LSzczur/smog-detector/README.md

## SMOG Detector - Homemade Air Pollution Sensor

Documentation is still in development stage - if you have any questions please contact me or create an issue.
