LSzczur/smog-detector/source/tools/README.txt

path to install:
C:\Program Files (x86)\Arduino\tools
