LSzczur/smog-detector/hardware/Schematic.pdf

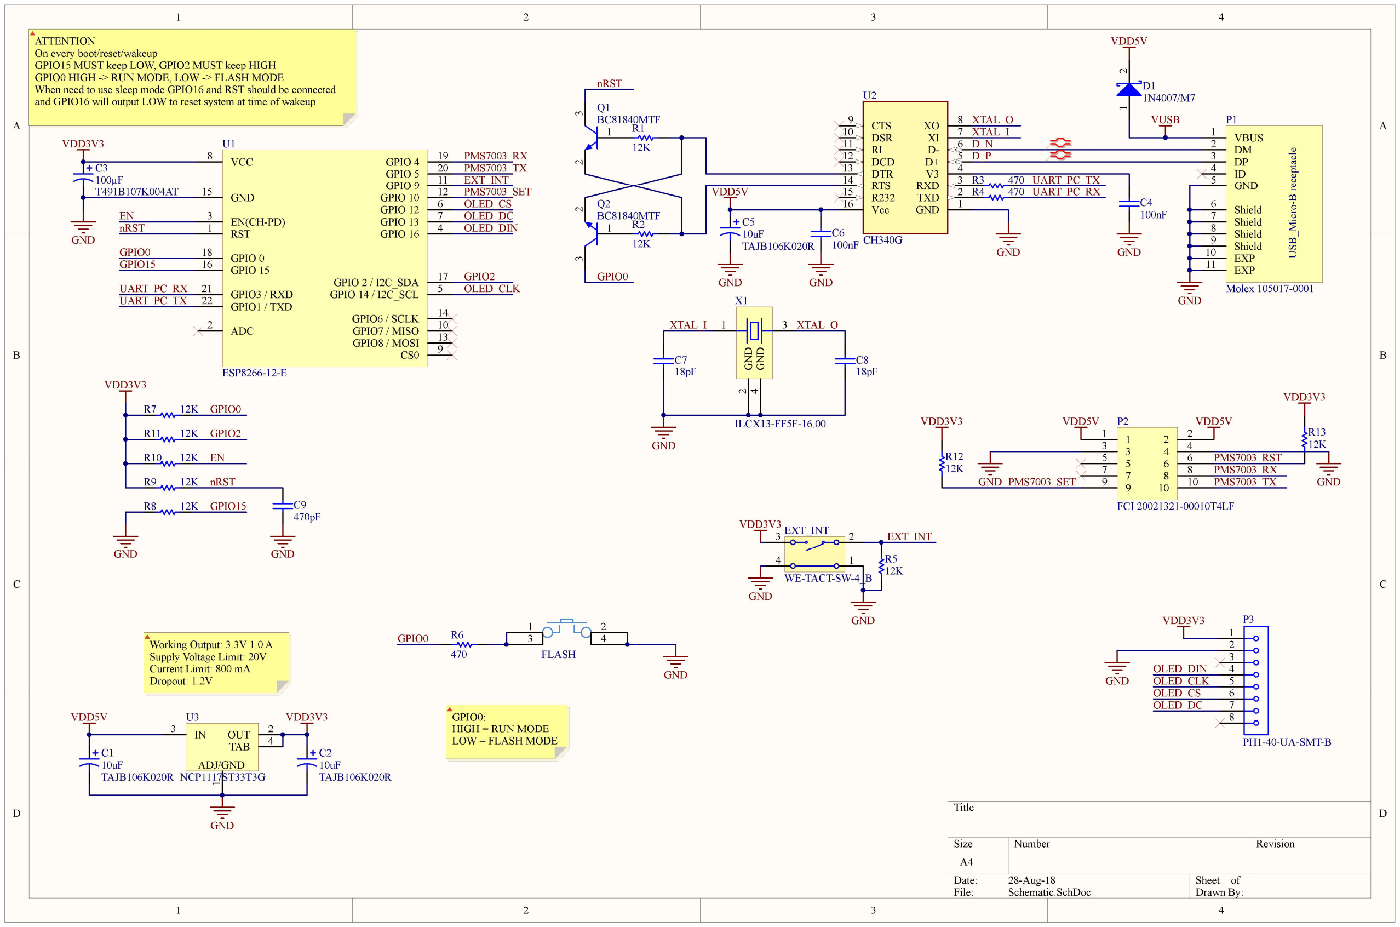
[picture p1: page 1]

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
Title

Size | Number | Revision
A4
Date: | 28-Aug-18 | Sheet of
File: | Schematic.SchDoc | Drawn By:

UART_PC_TX

UART_PC_RX

VBUS 1
DM 2
DP 3
ID 4
GND 5
Shield 6 | USB_Micro⁻B receptacle Shield 7

Shield 8
Shield 9
EXP 10
EXP 11

P1

Molex 105017-0001

VUSB

GND

VDD3V3

GND | 1
TXD | 2
D+ | 5
D- | 6
RXD | 3
V3 | 4

CTS 9
DSR 10

DTR 13
RTS 14
R232 15
Vcc 16
XI | 7
XO | 8

RI 11
DCD 12

U2

CH340G

R3 | 470
R4 | 470

UART_PC_TX
UART_PC_RX

GND

VDD5V

C6
100nF

GND
GND

C4
100nF

GND

XTAL_O
XTAL_I

T491B107K004AT

C3
100µF

1

OUT 2

IN 3
TAB 4

ADJ/GND

U3

NCP1117ST33T3G

1 2 3

Q1
BC81840MTF

### 1 ² 3

Q2

BC81840MTF | 1 2 | D1
| | 1N4007/M7

VDD5V

R1
12K

R2
12K

nRST

GPIO0

GND

VDD5V | VDD3V3

C9
470pF

VDD3V3

GND

1 3 GND

## 4 GND

2

X1

ILCX13-FF5F-16.00
GND

TAJB106K020R

C2
10uF
TAJB106K020R

C1
10uF

TAJB106K020R

C5
10uF

XTAL_O

GND

EN
nRST
R11 | 12K
R9 | 12K
R8 | 12K

GPIO0

GPIO2

EN

nRST

GPIO15

GND

GPIO0
GPIO15

PMS7003_RX
PMS7003_TX
EXT_INT
PMS7003_SET
OLED_CS
OLED_DC
OLED_DIN

GPIO2
OLED_CLK

VDD3V3

GND

OLED_DIN
OLED_CLK
OLED_CS
OLED_DC

D_N
D_P

XTAL_I

VDD5V | VDD5V
GND | GND

PMS7003_RST
PMS7003_RX
PMS7003_TX

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
10 10

P2

FCI 20021321-00010T4LF

GND

R7 12K GPIO0

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
PH1-40-UA-SMT-B

C8
18pF

C7
18pF

GND

GND

R5
12K

VDD3V3
EXT_INT

GPIO1 / TXD 22 GPIO3 / RXD 21

RST 1

EN(CH-PD) 3

GPIO8 / MOSI | 13 GPIO7 / MISO | 10 GPIO6 / SCLK | 14
CS0 | | | 9
GPIO 14 / I2C_SCL | 5
GPIO 2 / I2C_SDA | 17
GPIO 4 | 19
GPIO 5 | 20
GPIO 9 | 11
GPIO 10 | 12
GPIO 12 | 6
GPIO 13 | 7

GPIO 0 18
GPIO 15 16

GPIO 16 4

VCC 8

ADC 2

GND 15

U1

ESP8266-12-E

1 2
3 4
FLASH

1

3 2

4

EXT_INT

WE-TACT-SW-4_B

R10 | 12K | R12 12K

VDD3V3
R13
12K

VDD3V3

PMS7003_SET

ATTENTION
On every boot/reset/wakeup
GPIO15 MUST keep LOW, GPIO2 MUST keep HIGH
GPIO0 HIGH -> RUN MODE, LOW -> FLASH MODE
When need to use sleep mode GPIO16 and RST should be connected and GPIO16 will output LOW to reset system at time of wakeup

Working Output: 3.3V 1.0 A Supply Voltage Limit: 20V
Current Limit: 800 mA
Dropout: 1.2V

GPIO0:
HIGH = RUN MODE
LOW = FLASH MODE
