LSzczur/smog-detector/hardware/Assembly Drawings.pdf

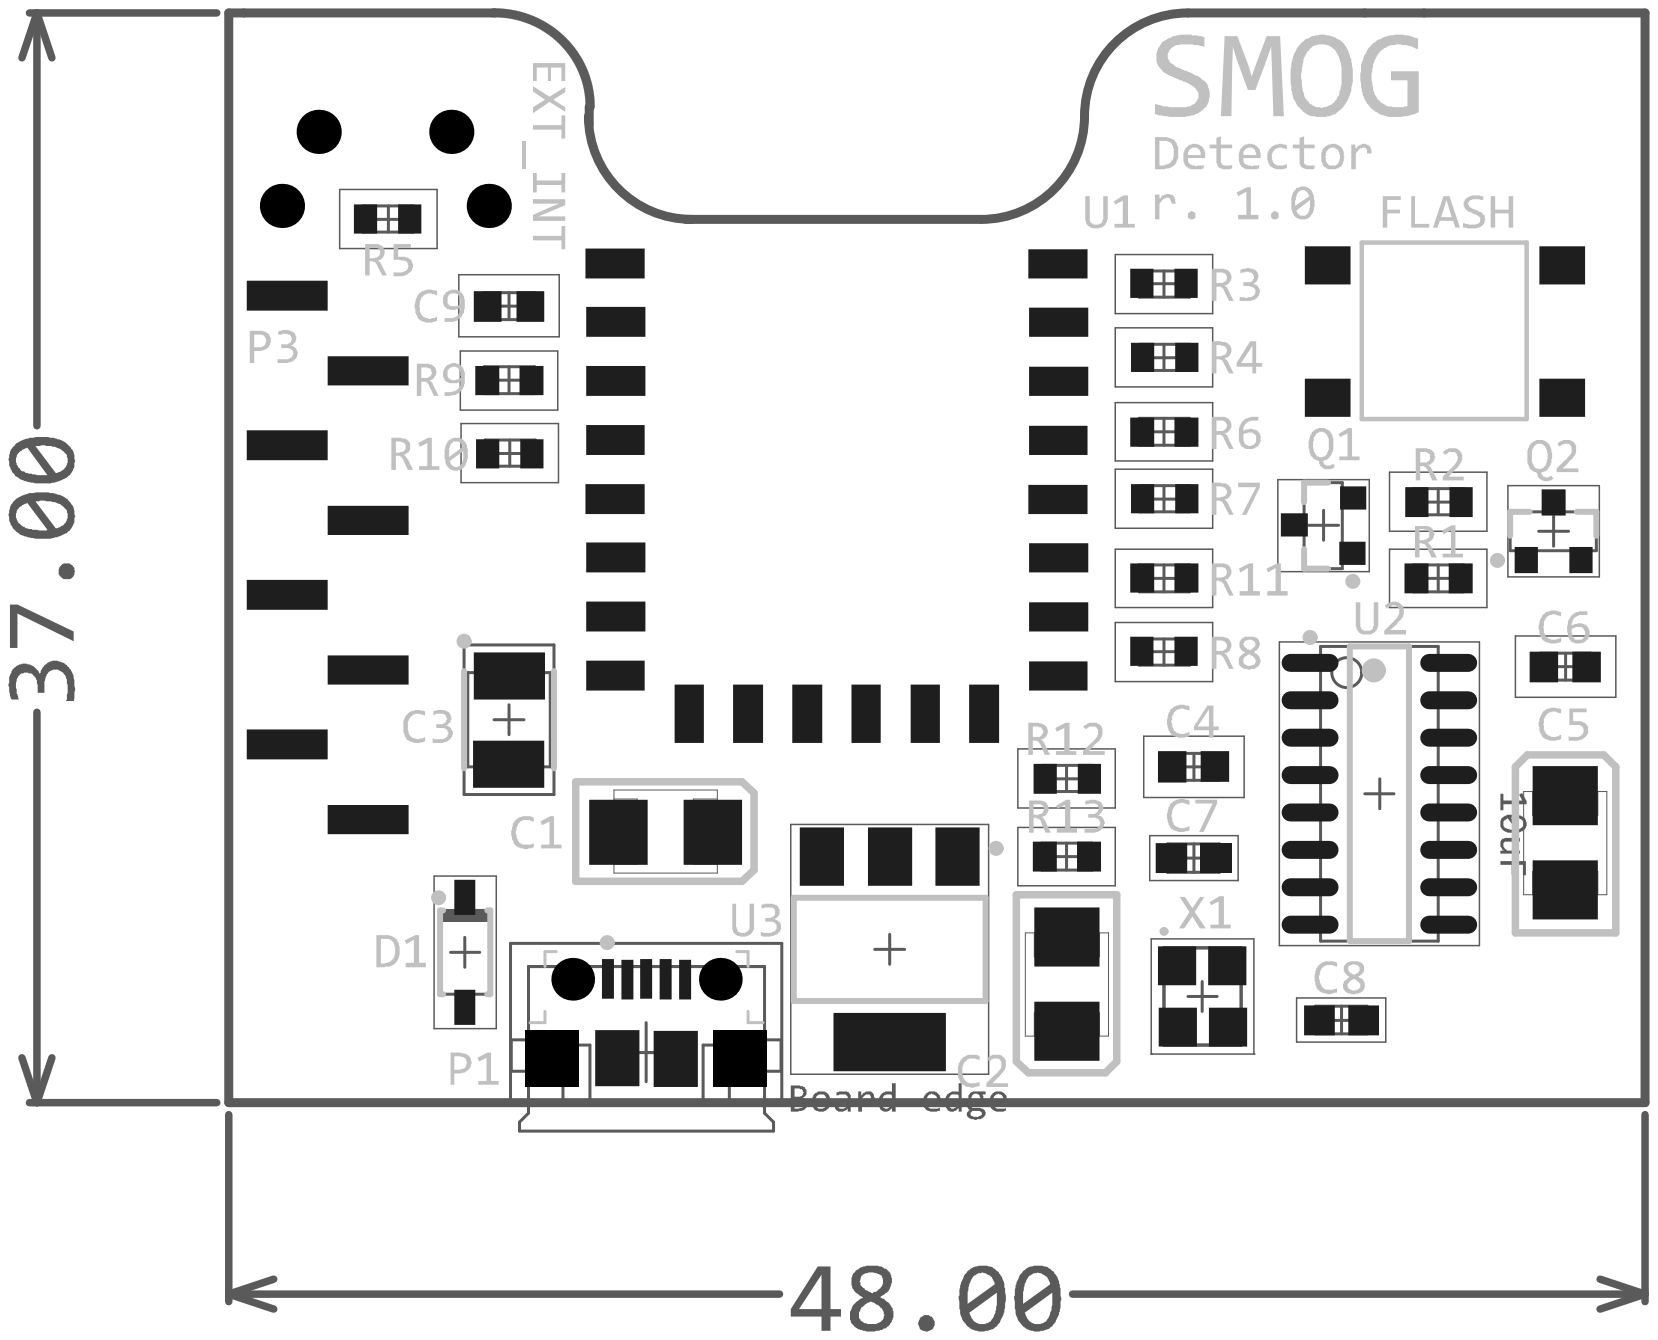
[picture p2: page 1]

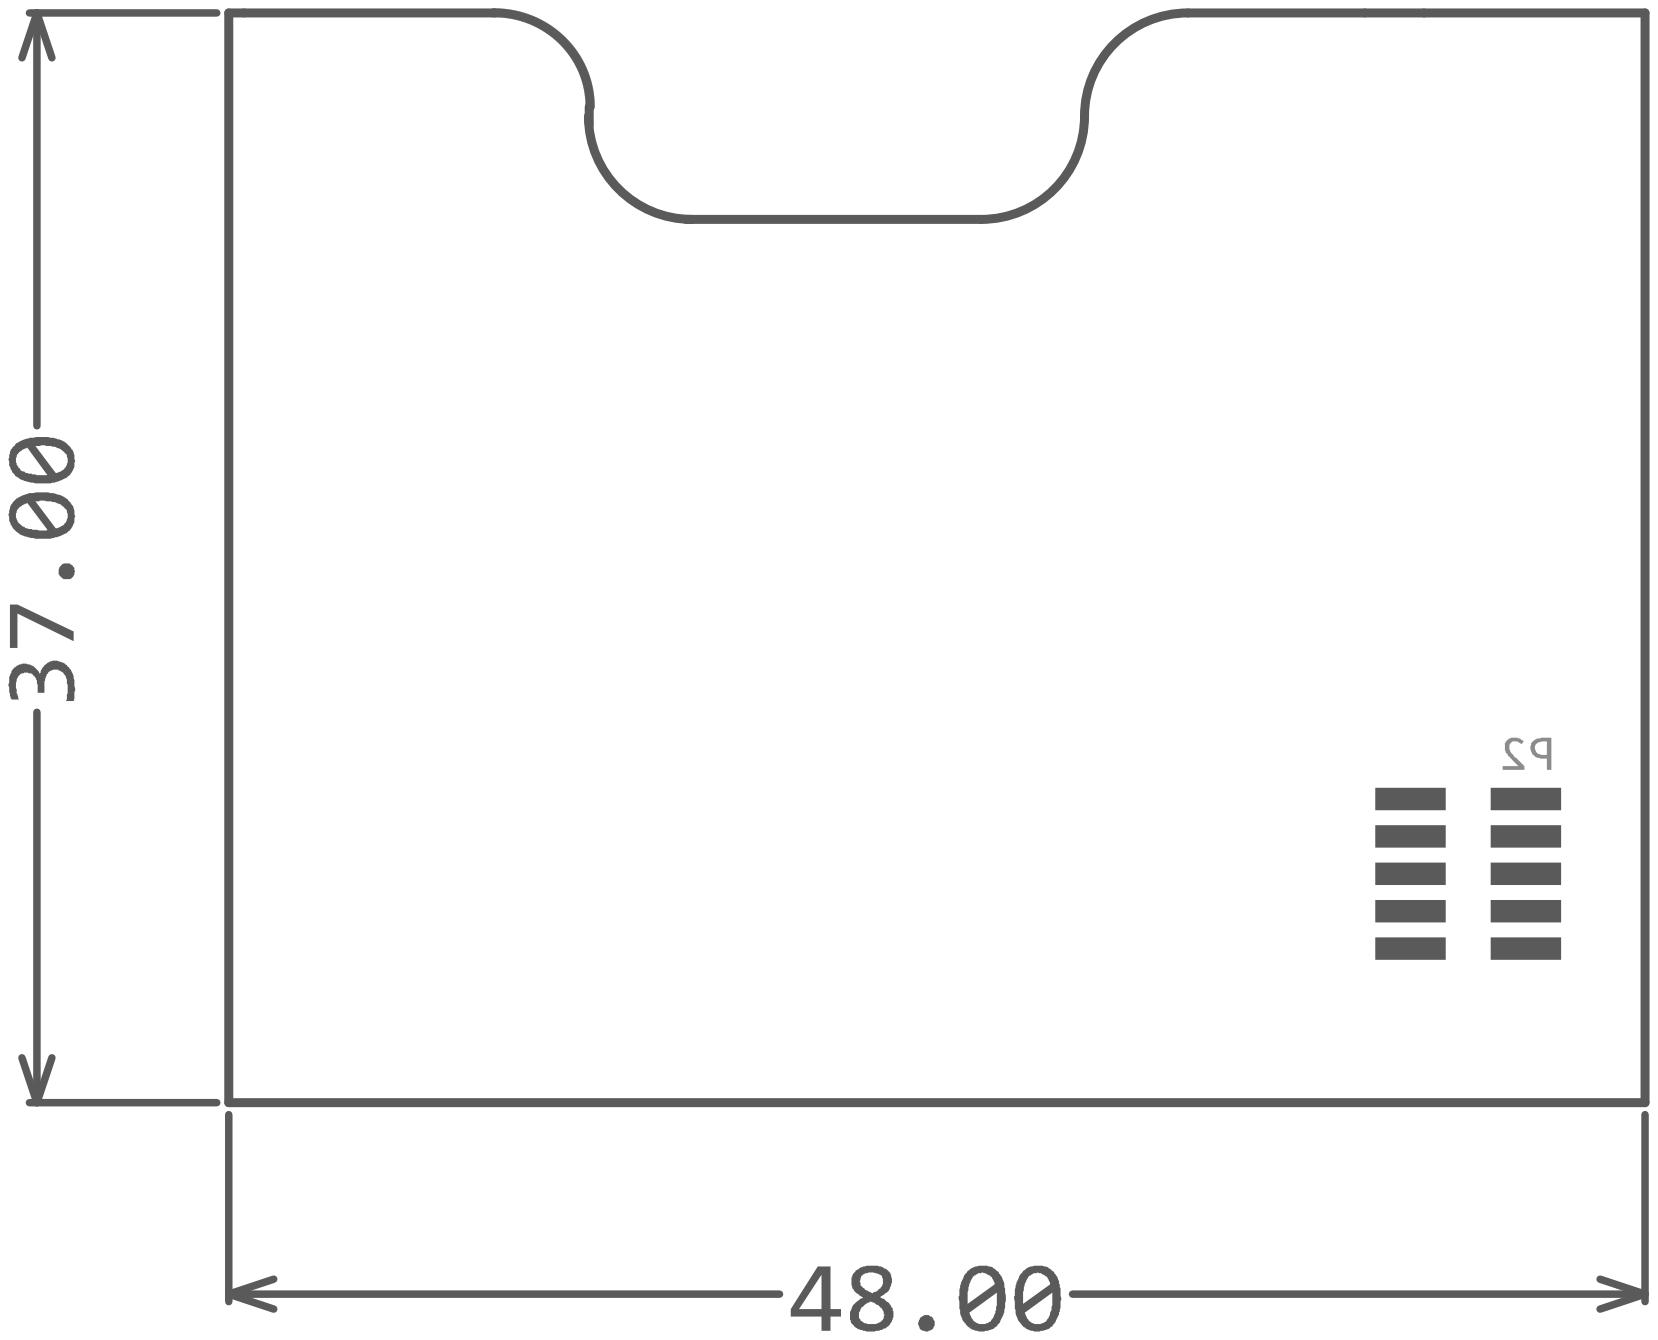
[picture p3: page 2]
