LSzczur/smog-detector/source/Smog_Detector/DustSensor.cpp

#include "DustSensor.hpp"
#include "settings.h"

DustSensor::DustSensor() :
    pms( /* RX=*/5, /* TX=*/4 ),
    dataStructure()
{
}

DustSensor::~DustSensor()
{
}

void DustSensor::Initialize()
{
    pms.begin();
    pms.waitForData(Pmsx003::wakeupTime);
    pms.write(Pmsx003::cmdModeActive);
}

Pmsx003::PmsStatus DustSensor::UpdateData()
{
    // Temporary table to use in library
    uint16_t data[Pmsx003::Reserved];

    Pmsx003::PmsStatus status = pms.read( data, Pmsx003::Reserved );

#ifdef DEBUG_MODE
    auto        newRead  = millis();
    static auto lastRead = 0;
#endif

    switch ( status )
    {
        case Pmsx003::OK:
            // Rewrite data to internal data structure
            dataStructure = DataStructure(data);
#ifdef DEBUG_MODE
            Serial.println( "_________________" );
            newRead = millis();
            Serial.print( "Wait time " );
            Serial.println( newRead - lastRead );
            lastRead = newRead;

            // For loop starts from 3
            // Skip the first three data (PM1dot0CF1, PM2dot5CF1, PM10CF1)
            for ( size_t i = Pmsx003::PM1dot0; i < Pmsx003::Reserved; ++i )
            {
                Serial.print( data[i] );
                Serial.print( "\t" );
                Serial.print( Pmsx003::dataNames[i] );
                Serial.print( " [" );
                Serial.print( Pmsx003::metrics[i] );
                Serial.print( "]" );
                Serial.println();
            }
#endif
            break;
        case Pmsx003::noData:
            break;
        default:
#ifdef DEBUG_MODE
            Serial.println( "_________________" );
            Serial.println( Pmsx003::errorMsg[status] );
#endif
            break;
    }

    return status;
}

DataStructure& DustSensor::GetDataStructure()
{
    return dataStructure;
}
