LSzczur/smog-detector/source/Smog_Detector/MQTTHandle.hpp

#ifndef MQTTHANDLE_HPP
#define MQTTHANDLE_HPP

#include <Arduino.h>
#include <PubSubClient.h>
#include <ESP8266WiFi.h>
#include <Ticker.h>

#include "DataStructure.hpp"

class MQTTHandle
{
public:
    // Constructor
    MQTTHandle();

    // Destructor
    ~MQTTHandle();

    // Initialize class
    IPAddress Initialize();

    // Callback method
    static void Callback(char * topic, byte * payload, unsigned int length);

    // MQTT Loop Handle
    void Loop(const DataStructure& dataToSend);

    static void Interrupt();

private:

    // Initialize WiFi object
    IPAddress WiFiInitialize();

    // Initialize MQTT object
    void MQTTInitialize();

    // Reconnect MQTT
    bool Reconnect();

    // Publish data
    void PublishData(const DataStructure& dataToSend);

    // ESP8266 WiFi client object
    WiFiClient wifiClient;

    // MQTT client object
    PubSubClient mqttClient;

    // Milliseconds since last reconnect attempt
    long lastReconnectAttempt;

    // Interrupt handler object
    Ticker ticker;

    // Flag indicate timer overflow - mqqt data needs to be pushed
    static bool isMqttReadyToSendData;
};

#endif
