LSzczur/smog-detector/(commit log)

2018-08-13 Added hardware files, moved source
    [PCB.GBL, PCB.GBO, PCB.GBP, PCB.GBS, PCB.GKO, PCB.GTL, PCB.GTO, PCB.GTP]
2018-08-13 Connection between OLED display and PMS7003 sensor
2018-08-28 Added Schematic
2018-09-21 Added Interrupt Handler
2019-04-02 Added printing Host Name to Serial log
2019-04-02 Temporary remove button attach - change in hardware needed
2019-04-20 Added timer interrupt object (ticker)
2019-11-03 Fix: Sensor crash after losting connection to WiFi
    [MQTTHandle.cpp]
2019-11-03 Removed DataStructure operator= and replaced it by converting constructor
    [DataStructure.hpp, DustSensor.cpp]
